Fontys-Pong/pong-PCB/pong_pcb/pong_pcb.kicad_pcb

## KiCad design pong_pcb/pong_pcb.kicad_pcb (2025-02-24)

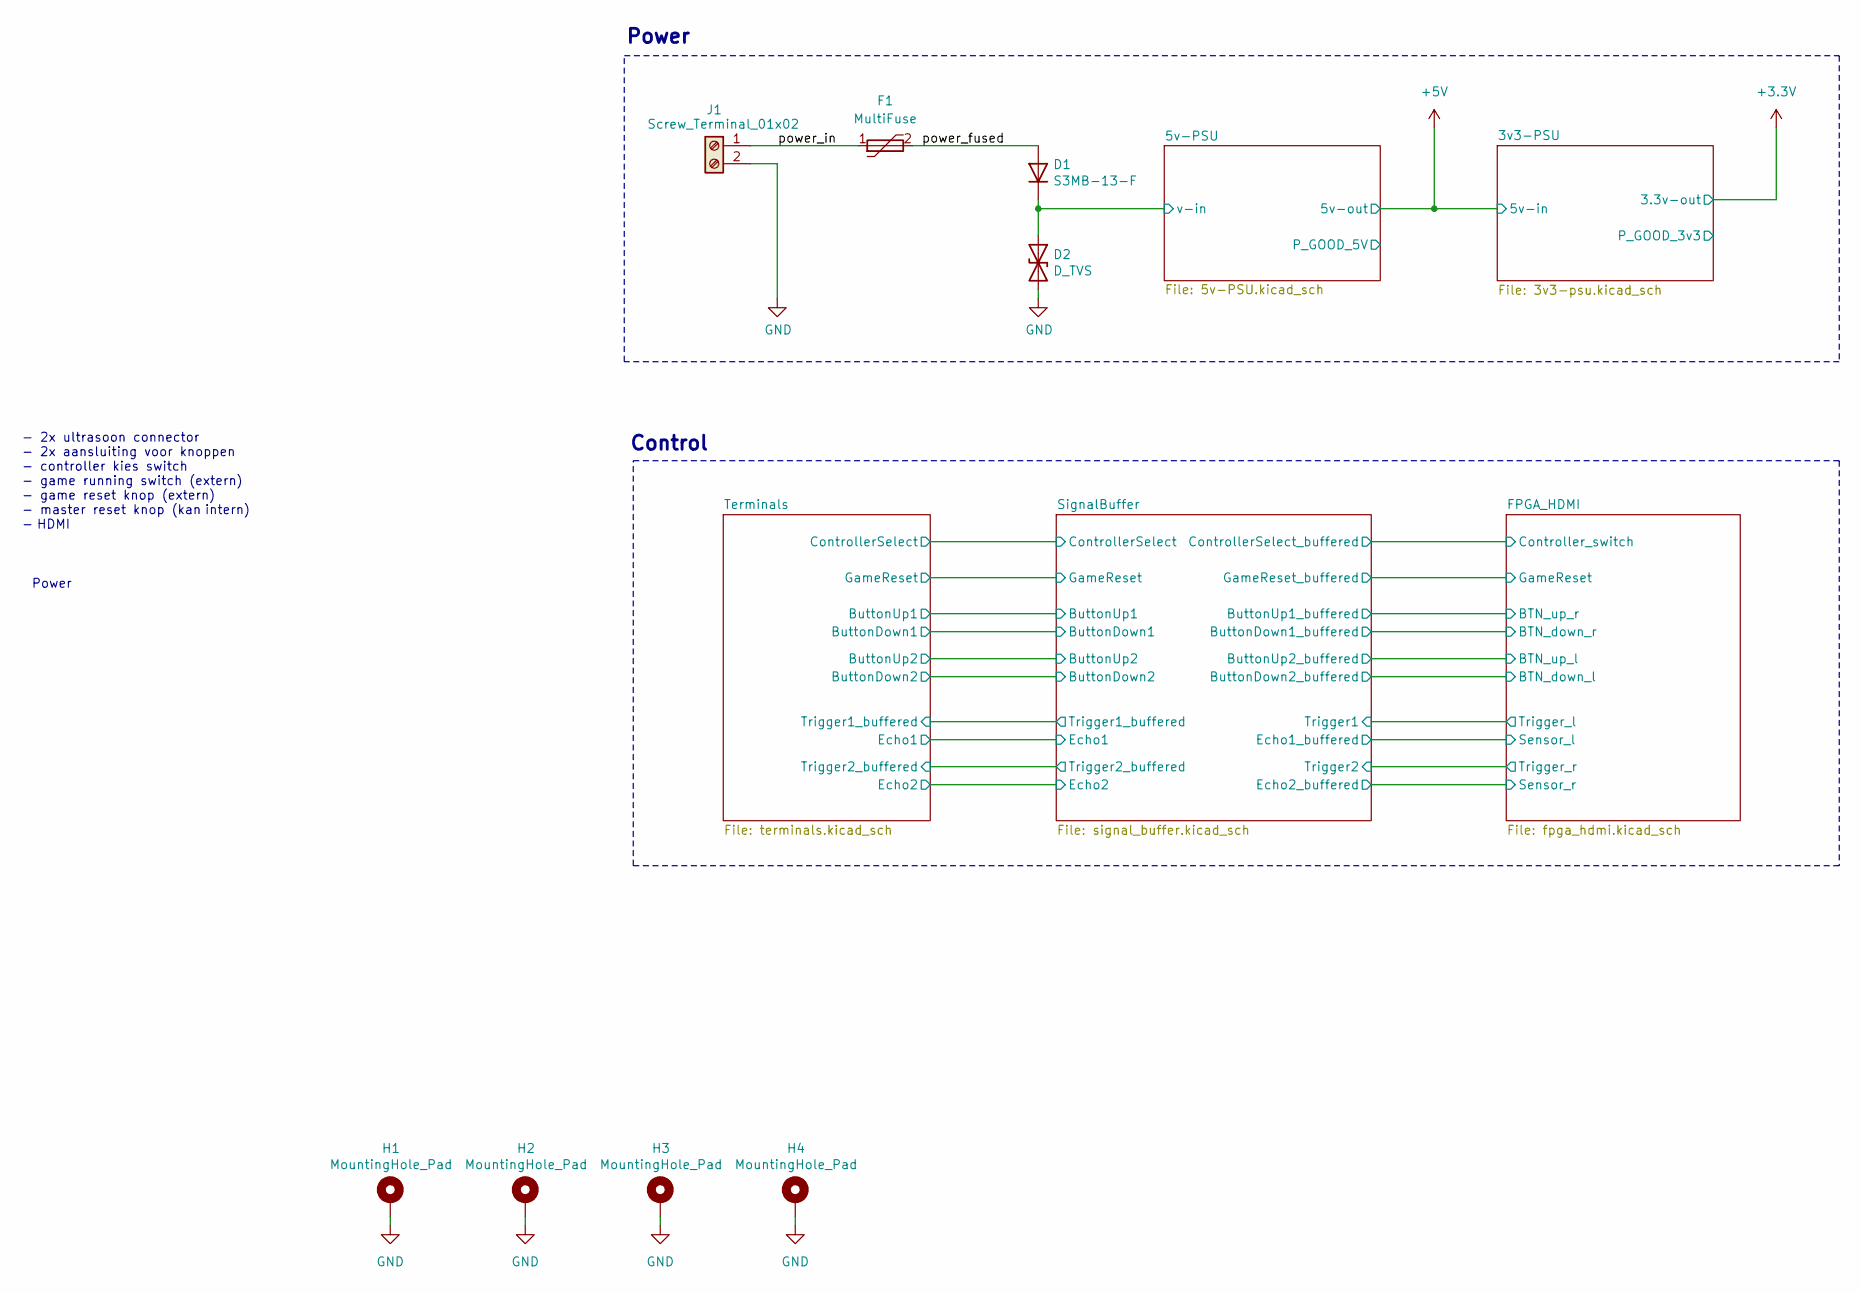
[picture p7: schematic pong_pcb.kicad_sch]

Parts:
D1: S3MB-13-F; D_SMB_Handsoldering; Mouser S3MB-13-F
D2: D_TVS; D_SMB_Handsoldering; Mouser 824520281
F1: MultiFuse; Fuse MF-MSMF075 33X-2; Mouser MF-MSMF075/33X-2
H1, H2, H3, H4: MountingHole_Pad; MountingHole_3.2mm_M3_Pad_Via
J1: Screw_Terminal_01x02; PhoenixContact_MSTBA_2,5_2-G-5,08_1x02_P5.08mm_Horizontal

Connections:
/5v-PSU/v-in: D1.1 (K), D2.1 (A1); also elsewhere on the board
/power_fused: D1.2 (A), F1.2
/power_in: F1.1, J1.1
GND: D2.2 (A2), H1.1, H2.1, H3.1, H4.1, J1.2; also elsewhere on the board

Notes on the sheet:
Power
- 2x ultrasoon connector - 2x aansluiting voor knoppen - controller kies switch - game running switch (extern) - game reset knop (extern) - master reset knop (kan intern) - HDMI
Control

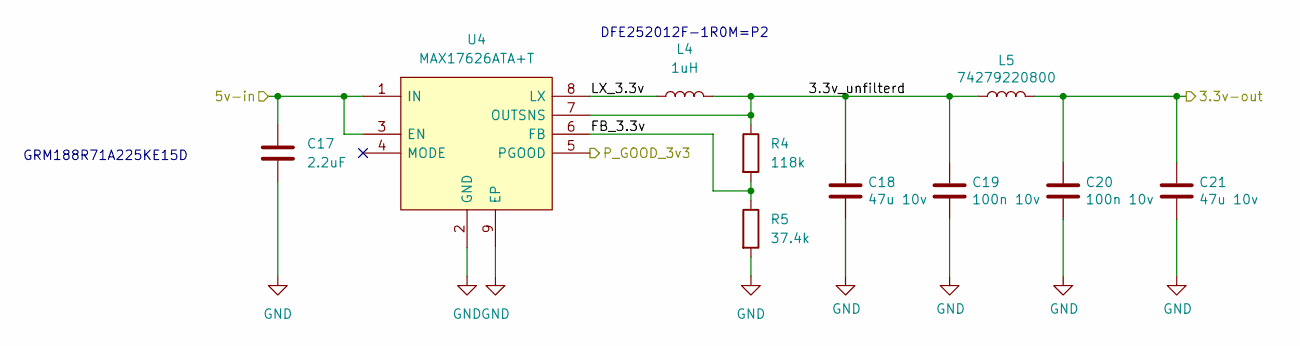
[picture p8: schematic 3v3-psu.kicad_sch, 3.3V power supply]

Parts:
C17: 2.2uF; C_0603_1608Metric
C18, C21: 47u 10v; C_1206_3216Metric_Pad1.33x1.80mm_HandSolder; Mouser LMK316BC6476ML-T
C19, C20: 100n 10v; C_0603_1608Metric; Mouser LMF105B7103MVHF
L4: 1uH; L_1008_2520Metric
L5: 74279220800; L_0805_2012Metric_Pad1.15x1.40mm_HandSolder; Mouser 74279220800
R4: 118k; R_0603_1608Metric
R5: 37.4k; R_0603_1608Metric
U4: MAX17626ATA+T; SON50P200X200X80-9N-D; Manufacturer_Part_Number MAX17626ATA+T; Mouser Part Number 700-MAX17626ATA+T

Connections:
+3.3V: C20.1, C21.1, L5.2; also elsewhere on the board
+5V: C17.1, U4.1 (IN), U4.3 (EN); also elsewhere on the board
/3v3-PSU/3.3v_unfilterd: C18.1, C19.1, L4.2, L5.1, R4.1, U4.7 (OUTSNS)
/3v3-PSU/FB_3.3v: R4.2, R5.1, U4.6 (FB)
/3v3-PSU/LX_3.3v: L4.1, U4.8 (LX)
/3v3-PSU/P_GOOD_3v3: U4.5 (PGOOD)
GND: C17.2, C18.2, C19.2, C20.2, C21.2, R5.2, U4.2 (GND), U4.9 (EP); also elsewhere on the board

Notes on the sheet:
GRM188R71A225KE15D
DFE252012F-1R0M=P2

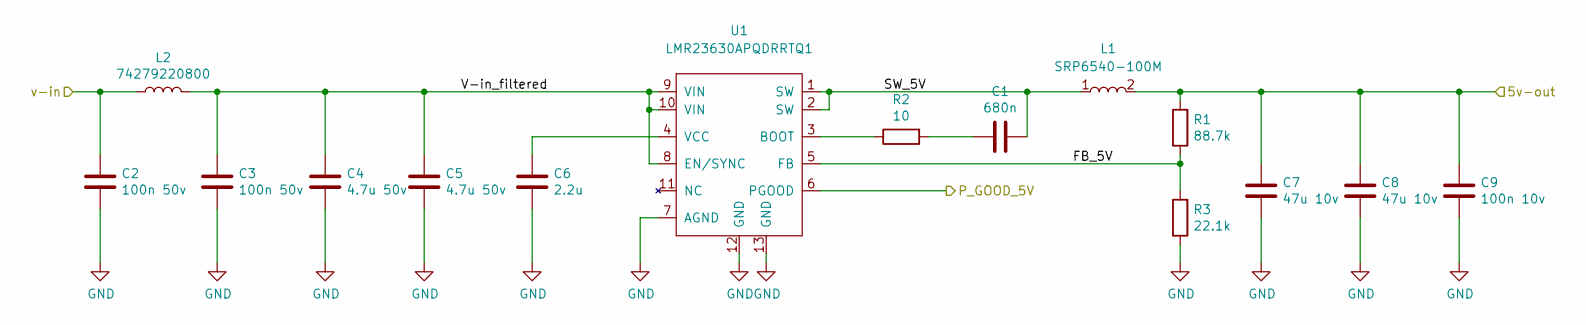
[picture p9: schematic 5v-PSU.kicad_sch, 5V power supply]

Parts:
C1: 680n; C_0603_1608Metric_Pad1.08x0.95mm_HandSolder; Mouser CGA3E1X7R1E684K080AC
C2, C3: 100n 50v; C_0805_2012Metric_Pad1.18x1.45mm_HandSolder; Mouser C0805C104KMRECAUTO
C4, C5: 4.7u 50v; C_0805_2012Metric_Pad1.18x1.45mm_HandSolder; Mouser C2012X7R1H475K125AC
C6: 2.2u; C_0603_1608Metric_Pad1.08x0.95mm_HandSolder; Mouser 963-TMK105CBJ225KV-F
C7, C8: 47u 10v; C_1206_3216Metric_Pad1.33x1.80mm_HandSolder; Mouser LMK316BC6476ML-T
C9: 100n 10v; C_0603_1608Metric; Mouser LMF105B7103MVHF
L1: SRP6540-100M; Mouser SRP6540-100M
L2: 74279220800; L_0805_2012Metric_Pad1.15x1.40mm_HandSolder; Mouser 74279220800
R1: 88.7k; R_0603_1608Metric; Mouser ERJ-2RKF8872X
R2: 10; R_0603_1608Metric; Mouser CRCW040210R0FKEDC
R3: 22.1k; R_0603_1608Metric; Mouser ERJ-2RHD2212X
U1: LMR23630APQDRRTQ1; Mouser LMR23630APQDRRTQ1

Connections:
+5V: C7.1, C8.1, C9.1, L1.2, R1.2; also elsewhere on the board
/5v-PSU/FB_5V: R1.1, R3.2, U1.5 (FB)
/5v-PSU/P_GOOD_5V: U1.6 (PGOOD)
/5v-PSU/SW_5V: C1.1, L1.1, U1.1 (SW), U1.2 (SW)
/5v-PSU/V-in_filtered: C3.1, C4.1, C5.1, L2.2, U1.8 (EN/SYNC), U1.9 (VIN), U1.10 (VIN)
/5v-PSU/v-in: C2.1, L2.1; also elsewhere on the board
GND: C2.2, C3.2, C4.2, C5.2, C6.2, C7.2, C8.2, C9.2, R3.1, U1.7 (AGND), U1.12 (GND), U1.13 (GND); also elsewhere on the board
unnamed: C1.2, R2.2
unnamed: R2.1, U1.3 (BOOT)
unnamed: C6.1, U1.4 (VCC)

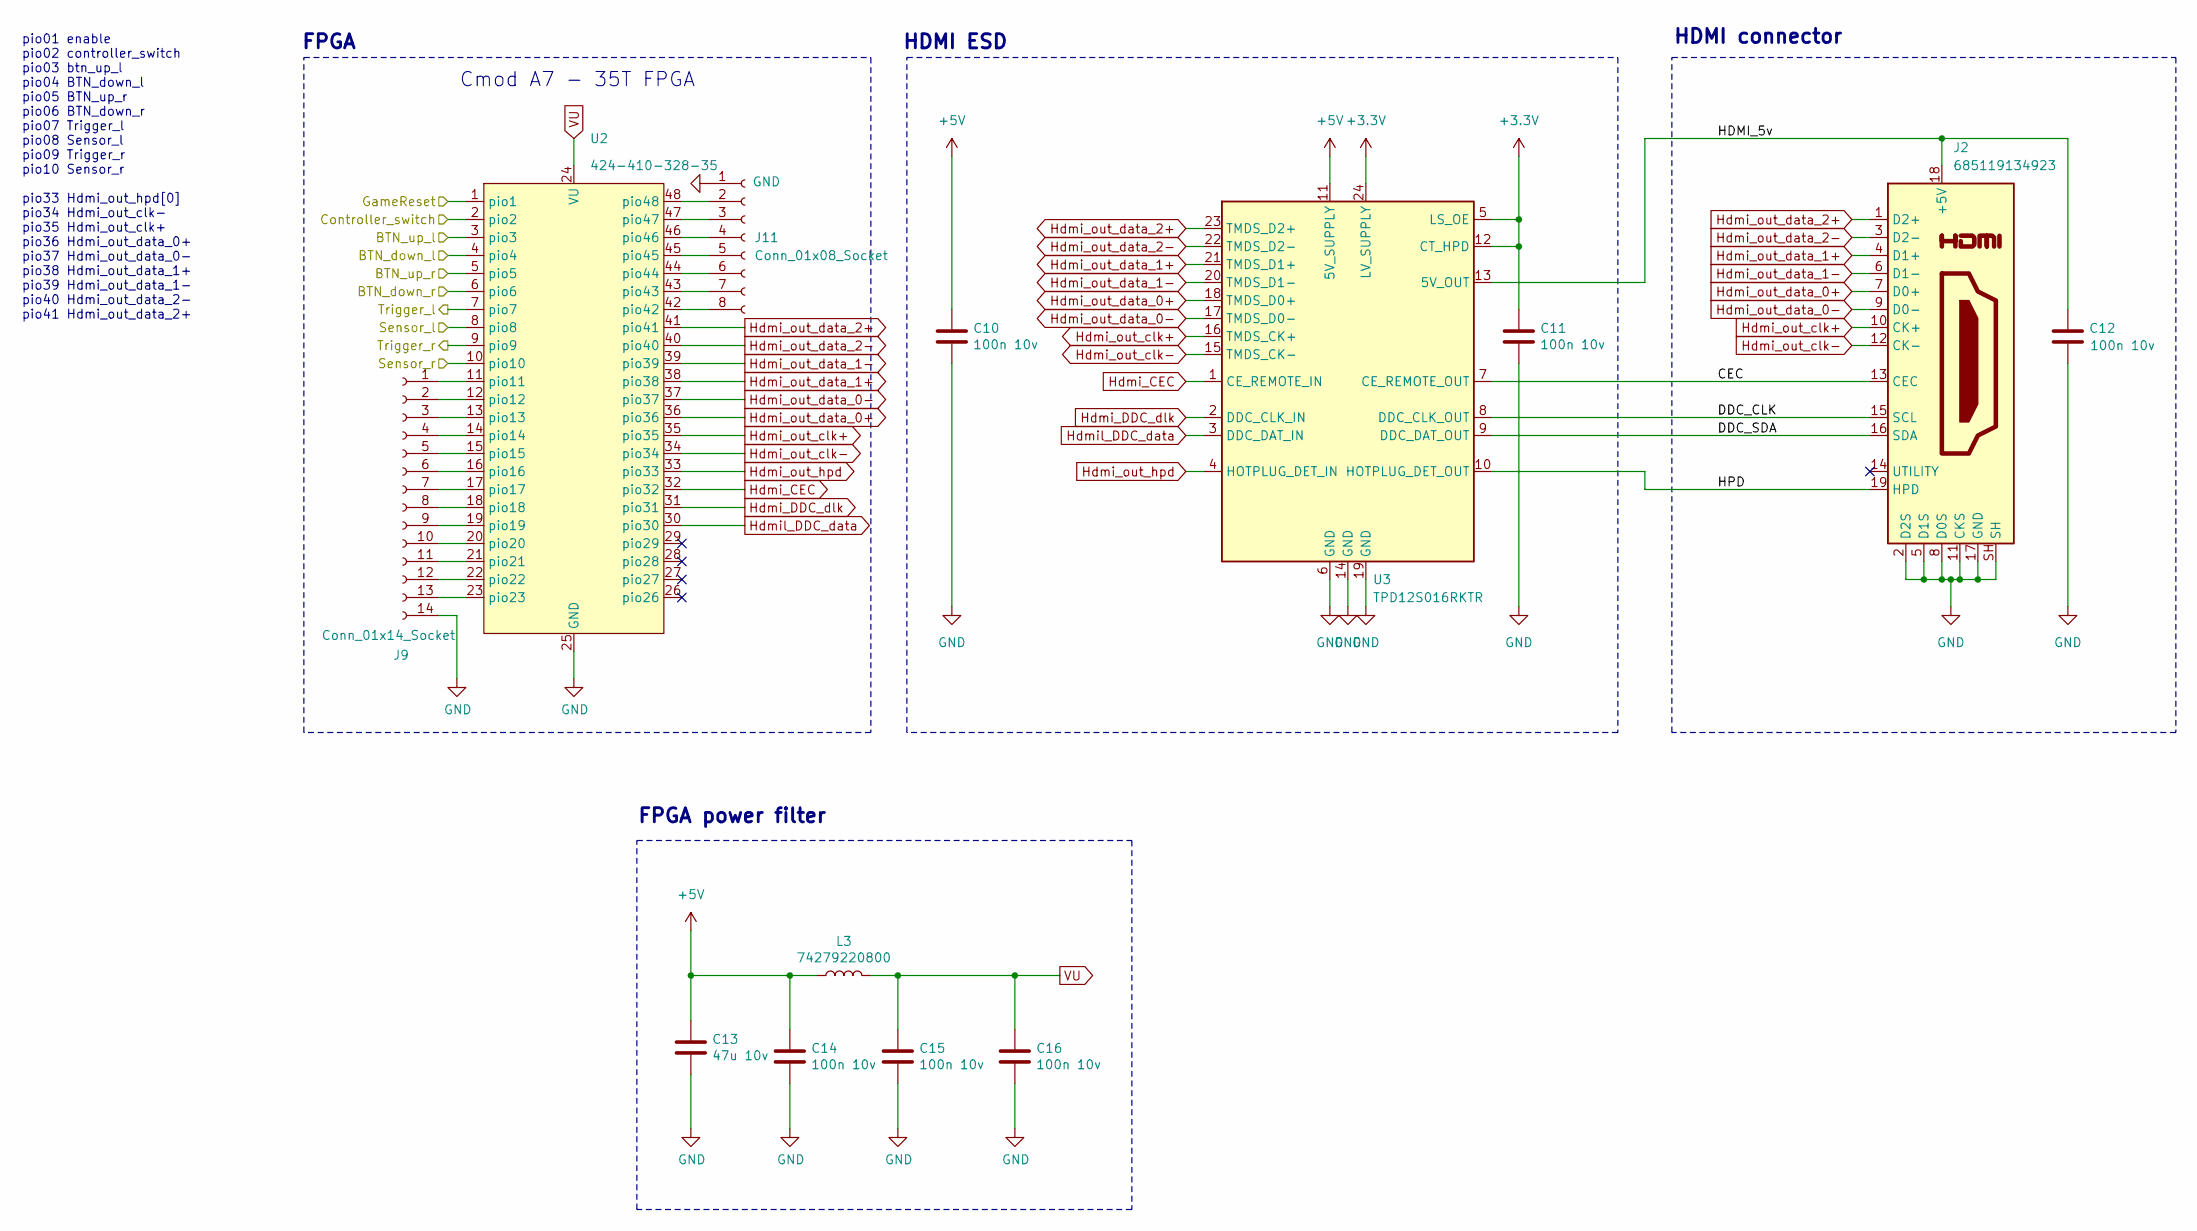
[picture p10: schematic fpga_hdmi.kicad_sch, FPGA + HDMI]

Parts:
C10, C11, C12, C14, C15, C16: 100n 10v; C_0603_1608Metric; Mouser LMF105B7103MVHF
C13: 47u 10v; C_1206_3216Metric_Pad1.33x1.80mm_HandSolder; Mouser LMK316BC6476ML-T
J2: 685119134923
J9: Conn_01x14_Socket; PinSocket_2x07_P2.54mm_Vertical
J11: Conn_01x08_Socket; PinSocket_2x04_P2.54mm_Vertical
L3: 74279220800; L_0805_2012Metric_Pad1.15x1.40mm_HandSolder; Mouser 74279220800
U2: CmodA7; Mouser 424-410-328-35
U3: TPD12S016RKTR; TSSOP-24_4.4x7.8mm_P0.65mm

Connections:
+3.3V: C11.1, U3.5 (LS_OE), U3.12 (CT_HPD), U3.24 (LV_SUPPLY); also elsewhere on the board
+5V: C10.1, C13.1, C14.1, L3.1, U3.11 (5V_SUPPLY); also elsewhere on the board
/FPGA_HDMI/BTN_down_l: U2.4 (pio4); also elsewhere on the board
/FPGA_HDMI/BTN_down_r: U2.6 (pio6); also elsewhere on the board
/FPGA_HDMI/BTN_up_l: U2.3 (pio3); also elsewhere on the board
/FPGA_HDMI/BTN_up_r: U2.5 (pio5); also elsewhere on the board
/FPGA_HDMI/CEC: J2.13 (CEC), U3.7 (CE_REMOTE_OUT)
/FPGA_HDMI/Controller_switch: U2.2 (pio2); also elsewhere on the board
/FPGA_HDMI/DDC_CLK: J2.15 (SCL), U3.8 (DDC_CLK_OUT)
/FPGA_HDMI/DDC_SDA: J2.16 (SDA), U3.9 (DDC_DAT_OUT)
/FPGA_HDMI/GameReset: U2.1 (pio1); also elsewhere on the board
/FPGA_HDMI/HDMI_5v: C12.1, J2.18 (+5V), U3.13 (5V_OUT)
/FPGA_HDMI/HPD: J2.19 (HPD), U3.10 (HOTPLUG_DET_OUT)
/FPGA_HDMI/Sensor_l: U2.8 (pio8); also elsewhere on the board
/FPGA_HDMI/Sensor_r: U2.10 (pio10); also elsewhere on the board
/FPGA_HDMI/Trigger_l: U2.7 (pio7); also elsewhere on the board
/FPGA_HDMI/Trigger_r: U2.9 (pio9); also elsewhere on the board
GND: C10.2, C11.2, C12.2, C13.2, C14.2, C15.2, C16.2, J2.2 (D2S), J2.5 (D1S), J2.8 (D0S), J2.11 (CKS), J2.17 (GND), J2.SH, J9.14, J11.1, U2.25 (GND), U3.6 (GND), U3.14 (GND), U3.19 (GND); also elsewhere on the board
Hdmi_CEC: U2.32 (pio32), U3.1 (CE_REMOTE_IN)
Hdmi_DDC_dlk: U2.31 (pio31), U3.2 (DDC_CLK_IN)
Hdmi_out_clk+: J2.10 (CK+), U2.35 (pio35), U3.16 (TMDS_CK+)
Hdmi_out_clk-: J2.12 (CK-), U2.34 (pio34), U3.15 (TMDS_CK-)
Hdmi_out_data_0+: J2.7 (D0+), U2.36 (pio36), U3.18 (TMDS_D0+)
Hdmi_out_data_0-: J2.9 (D0-), U2.37 (pio37), U3.17 (TMDS_D0-)
Hdmi_out_data_1+: J2.4 (D1+), U2.38 (pio38), U3.21 (TMDS_D1+)
Hdmi_out_data_1-: J2.6 (D1-), U2.39 (pio39), U3.20 (TMDS_D1-)
Hdmi_out_data_2+: J2.1 (D2+), U2.41 (pio41), U3.23 (TMDS_D2+)
Hdmi_out_data_2-: J2.3 (D2-), U2.40 (pio40), U3.22 (TMDS_D2-)
Hdmi_out_hpd: U2.33 (pio33), U3.4 (HOTPLUG_DET_IN)
Hdmil_DDC_data: U2.30 (pio30), U3.3 (DDC_DAT_IN)
unnamed: J9.1, U2.11 (pio11)
unnamed: J9.2, U2.12 (pio12)
unnamed: J9.3, U2.13 (pio13)
unnamed: J9.4, U2.14 (pio14)
unnamed: J9.5, U2.15 (pio15)
unnamed: J9.6, U2.16 (pio16)
unnamed: J9.7, U2.17 (pio17)
unnamed: J9.8, U2.18 (pio18)
unnamed: J9.9, U2.19 (pio19)
unnamed: J9.10, U2.20 (pio20)
unnamed: J9.11, U2.21 (pio21)
unnamed: J9.12, U2.22 (pio22)
unnamed: J9.13, U2.23 (pio23)
unnamed: J11.2, U2.48 (pio48)
unnamed: J11.3, U2.47 (pio47)
unnamed: J11.4, U2.46 (pio46)
unnamed: J11.5, U2.45 (pio45)
unnamed: J11.6, U2.44 (pio44)
unnamed: J11.7, U2.43 (pio43)
unnamed: J11.8, U2.42 (pio42)
VU: C15.1, C16.1, L3.2, U2.24 (VU)

Notes on the sheet:
FPGA
pio01 enable pio02 controller_switch pio03 btn_up_l pio04 BTN_down_l pio05 BTN_up_r pio06 BTN_down_r pio07 Trigger_l pio08 Sensor_l pio09 Trigger_r pio10 Sensor_r pio33 Hdmi_out_hpd[0] pio34 Hdmi_out_clk- pio35 Hdmi_out_clk+ pio36 Hdmi_out_data_0+ pio37 Hdmi_out_data_0- pio38 Hdmi_out_data_1+ pio39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
FPGA power filter
Cmod A7 - 35T FPGA
HDMI ESD
HDMI connector

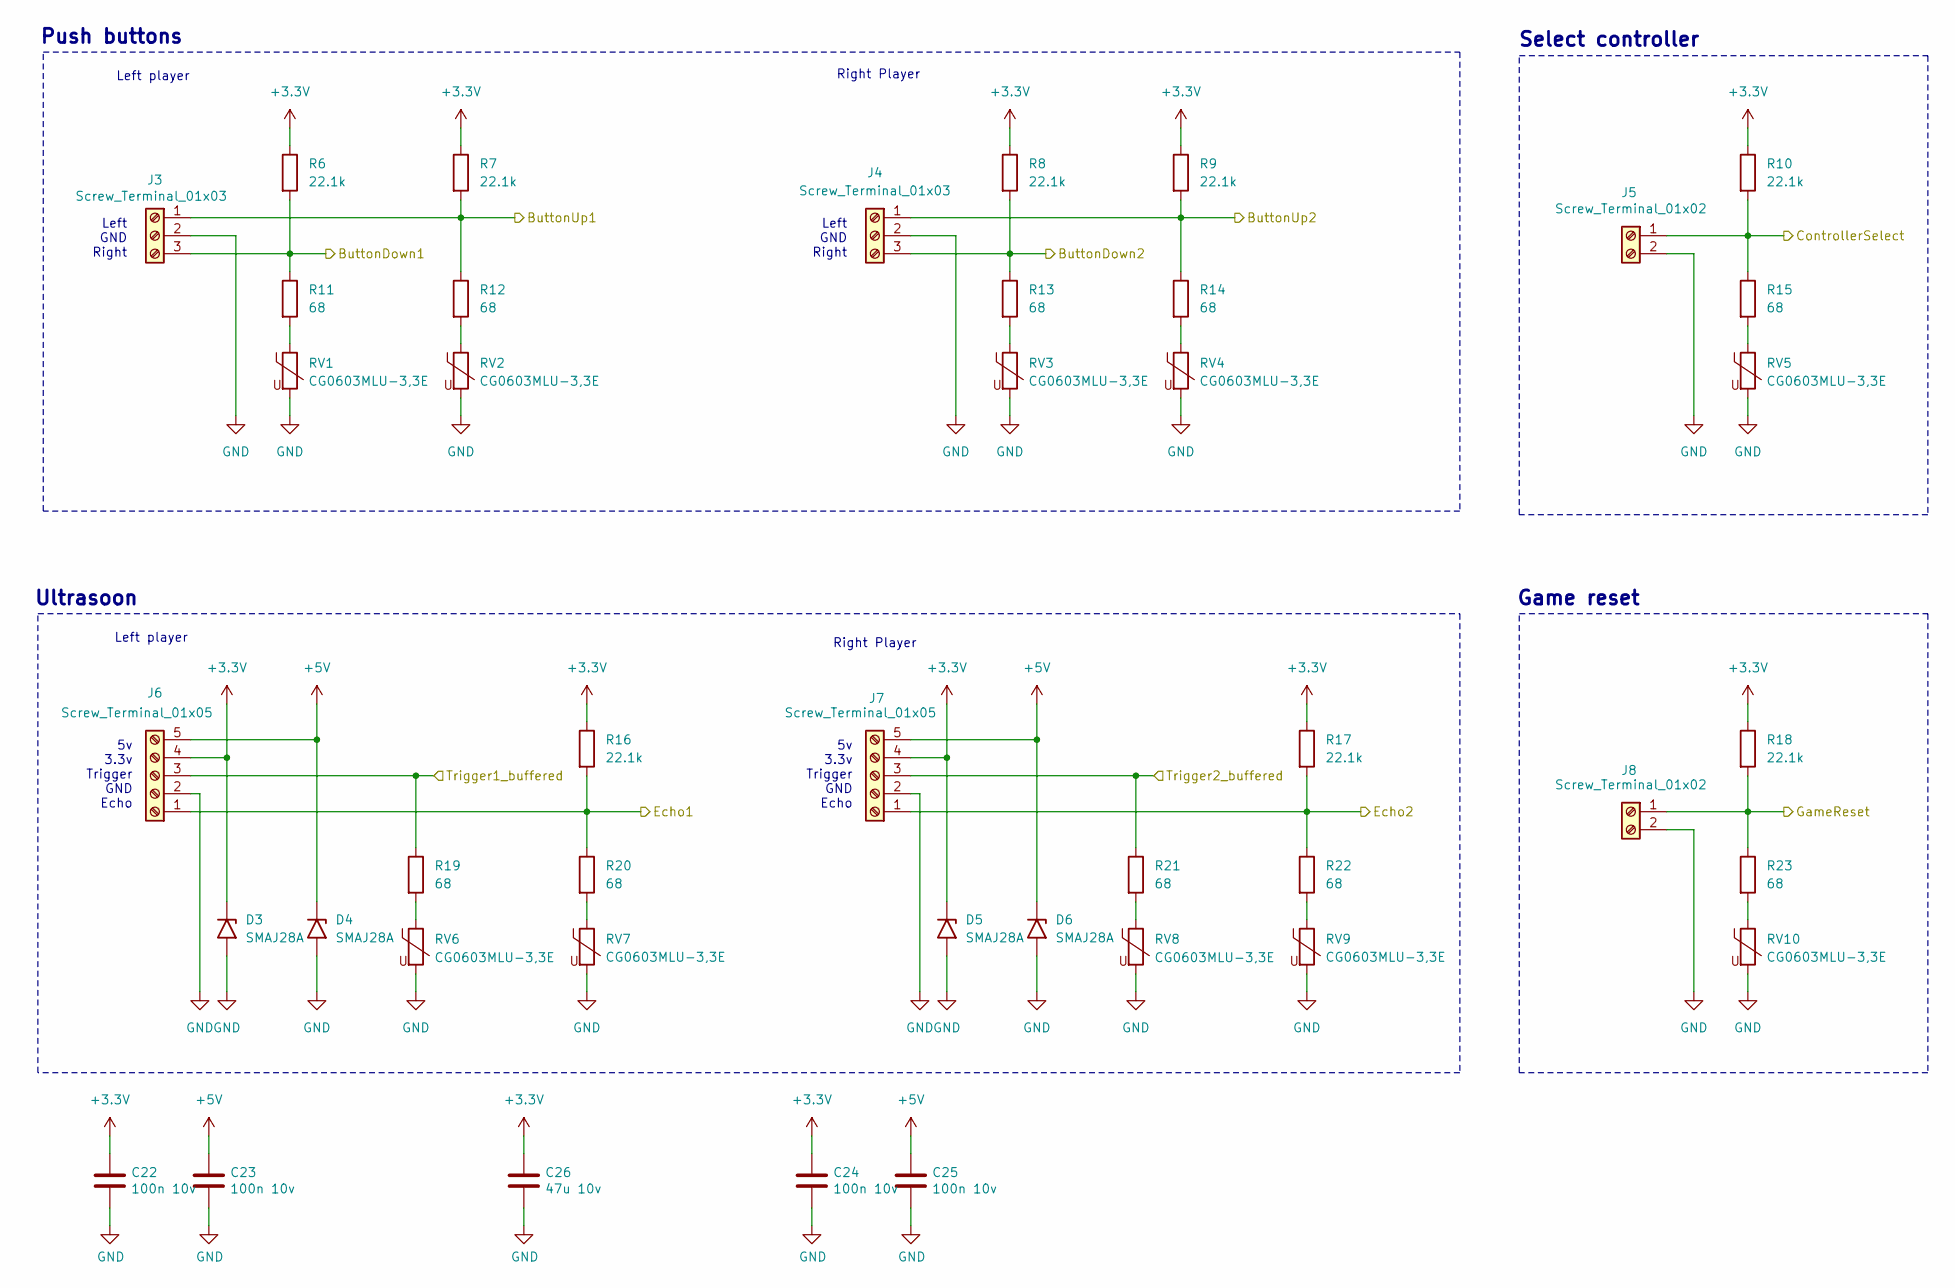
[picture p11: schematic terminals.kicad_sch]

Parts:
C22, C23, C24, C25: 100n 10v; C_0603_1608Metric; Mouser LMF105B7103MVHF
C26: 47u 10v; C_1206_3216Metric_Pad1.33x1.80mm_HandSolder; Mouser LMK316BC6476ML-T
D3, D4, D5, D6: SMAJ28A; D_SMA
J3, J4: Screw_Terminal_01x03; PhoenixContact_MSTBA_2,5_3-G-5,08_1x03_P5.08mm_Horizontal
J5, J8: Screw_Terminal_01x02; PhoenixContact_MSTBA_2,5_2-G-5,08_1x02_P5.08mm_Horizontal
J6, J7: Screw_Terminal_01x05; PhoenixContact_MSTBA_2,5_5-G-5,08_1x05_P5.08mm_Horizontal
R6, R7, R8, R9, R10, R16, R17, R18: 22.1k; R_0603_1608Metric
R11, R12, R13, R14, R15, R19, R20, R21, R22, R23: 68; R_0603_1608Metric
RV1, RV2, RV3, RV4, RV5, RV6, RV7, RV8, RV9, RV10: CG0603MLU-3,3E; R_0603_1608Metric

Connections:
+3.3V: C22.1, C24.1, C26.1, D3.1 (A1), D5.1 (A1), J6.4, J7.4, R6.1, R7.1, R8.1, R9.1, R10.1, R16.1, R17.1, R18.1; also elsewhere on the board
+5V: C23.1, C25.1, D4.1 (A1), D6.1 (A1), J6.5, J7.5; also elsewhere on the board
/SignalBuffer/ButtonDown1: J3.3, R6.2, R11.1; also elsewhere on the board
/SignalBuffer/ButtonDown2: J4.3, R8.2, R13.1; also elsewhere on the board
/SignalBuffer/ButtonUp1: J3.1, R7.2, R12.1; also elsewhere on the board
/SignalBuffer/ButtonUp2: J4.1, R9.2, R14.1; also elsewhere on the board
/SignalBuffer/ControllerSelect: J5.1, R10.2, R15.1; also elsewhere on the board
/SignalBuffer/Echo1: J6.1, R16.2, R20.1; also elsewhere on the board
/SignalBuffer/Echo2: J7.1, R17.2, R22.1; also elsewhere on the board
/SignalBuffer/GameReset: J8.1, R18.2, R23.1; also elsewhere on the board
/SignalBuffer/Trigger1_buffered: J6.3, R19.1; also elsewhere on the board
/SignalBuffer/Trigger2_buffered: J7.3, R21.1; also elsewhere on the board
GND: C22.2, C23.2, C24.2, C25.2, C26.2, D3.2 (A2), D4.2 (A2), D5.2 (A2), D6.2 (A2), J3.2, J4.2, J5.2, J6.2, J7.2, J8.2, RV1.2, RV2.2, RV3.2, RV4.2, RV5.2, RV6.2, RV7.2, RV8.2, RV9.2, RV10.2; also elsewhere on the board
unnamed: R11.2, RV1.1
unnamed: R12.2, RV2.1
unnamed: R13.2, RV3.1
unnamed: R14.2, RV4.1
unnamed: R15.2, RV5.1
unnamed: R19.2, RV6.1
unnamed: R20.2, RV7.1
unnamed: R21.2, RV8.1
unnamed: R22.2, RV9.1
unnamed: R23.2, RV10.1

Notes on the sheet:
5v 3.3v Trigger GND Echo
Ultrasoon
Game reset
Left GND Right
Push buttons
Left player
Right Player
Select controller

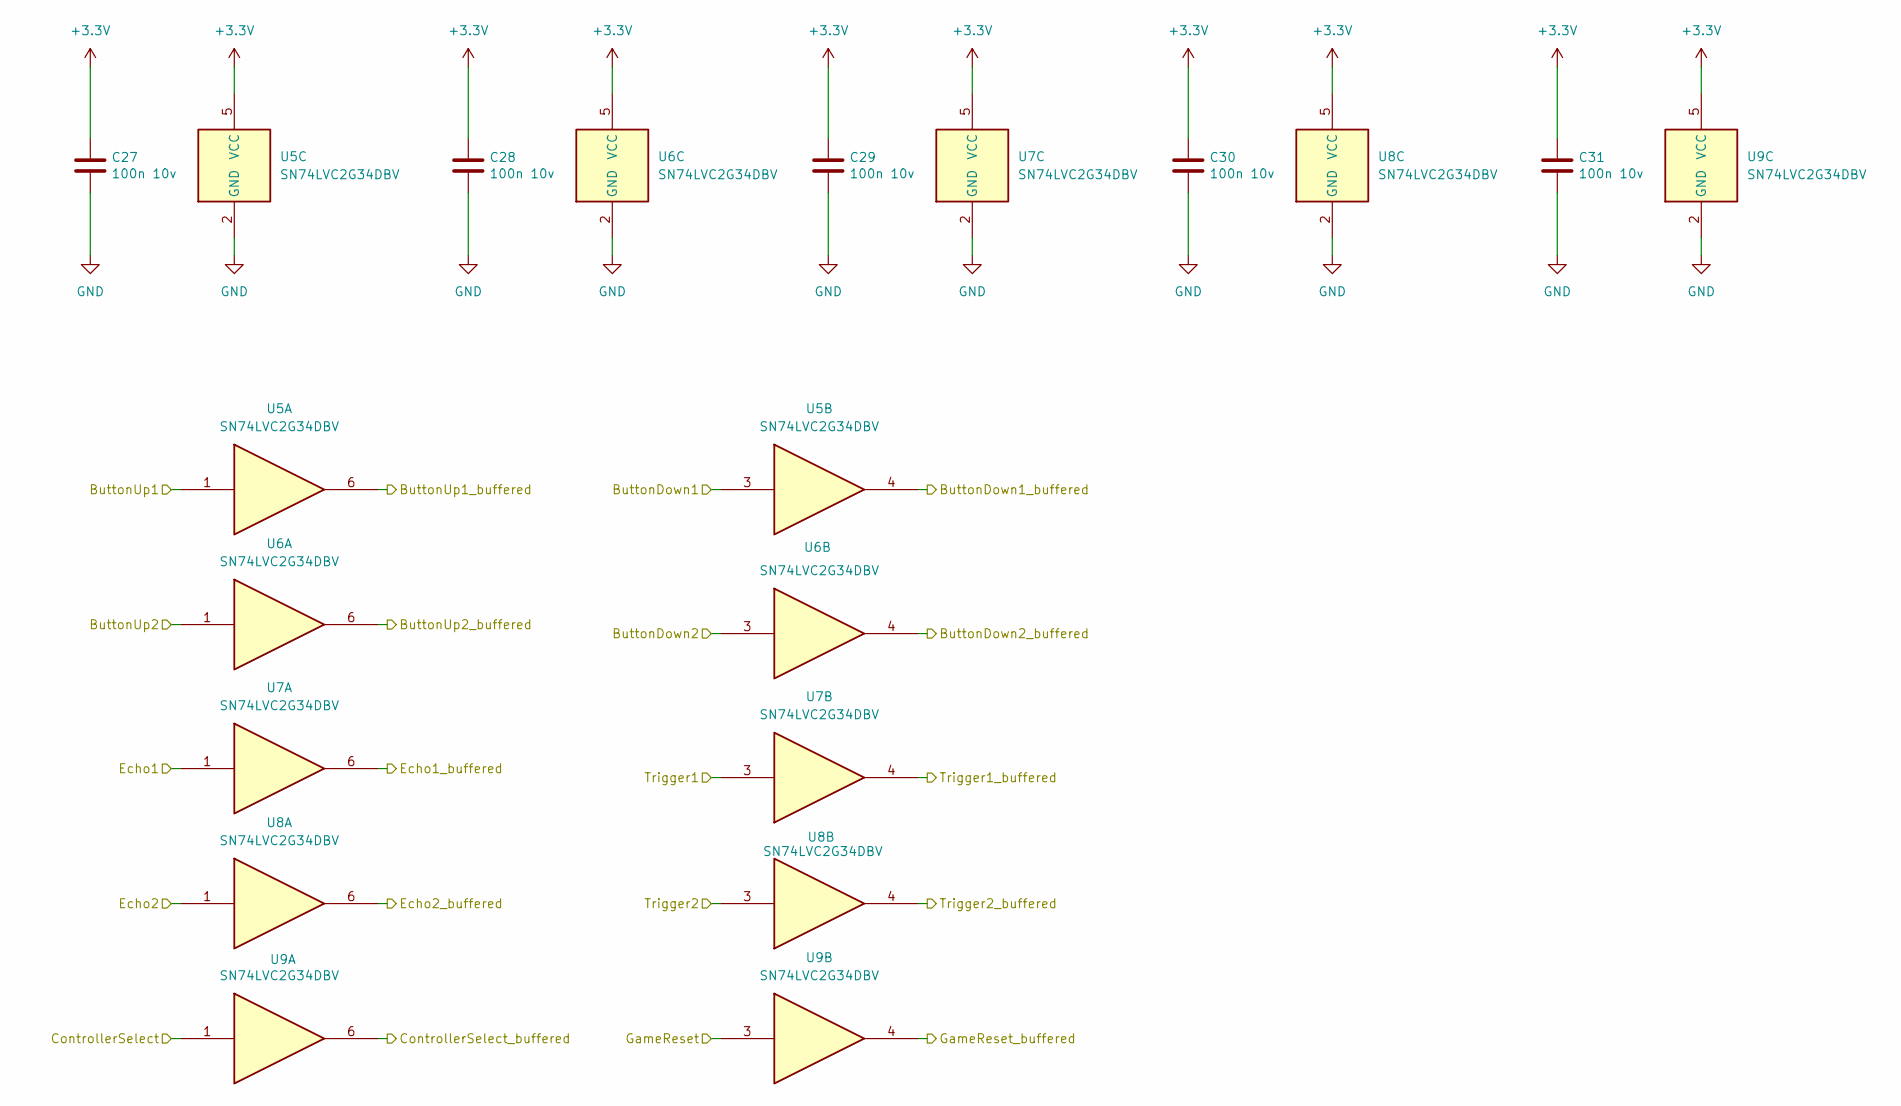
[picture p12: schematic signal_buffer.kicad_sch, Signal buffers]

Parts:
C27, C28, C29, C30, C31: 100n 10v; C_0603_1608Metric; Mouser LMF105B7103MVHF
U5, U6, U7, U8, U9: SN74LVC2G34DBV; SOT-23-6_Handsoldering

Connections:
+3.3V: C27.1, C28.1, C29.1, C30.1, C31.1, U5.5 (VCC), U6.5 (VCC), U7.5 (VCC), U8.5 (VCC), U9.5 (VCC); also elsewhere on the board
/FPGA_HDMI/BTN_down_l: U6.4; also elsewhere on the board
/FPGA_HDMI/BTN_down_r: U5.4; also elsewhere on the board
/FPGA_HDMI/BTN_up_l: U6.6; also elsewhere on the board
/FPGA_HDMI/BTN_up_r: U5.6; also elsewhere on the board
/FPGA_HDMI/Controller_switch: U9.6; also elsewhere on the board
/FPGA_HDMI/GameReset: U9.4; also elsewhere on the board
/FPGA_HDMI/Sensor_l: U7.6; also elsewhere on the board
/FPGA_HDMI/Sensor_r: U8.6; also elsewhere on the board
/FPGA_HDMI/Trigger_l: U7.3; also elsewhere on the board
/FPGA_HDMI/Trigger_r: U8.3; also elsewhere on the board
/SignalBuffer/ButtonDown1: U5.3; also elsewhere on the board
/SignalBuffer/ButtonDown2: U6.3; also elsewhere on the board
/SignalBuffer/ButtonUp1: U5.1; also elsewhere on the board
/SignalBuffer/ButtonUp2: U6.1; also elsewhere on the board
/SignalBuffer/ControllerSelect: U9.1; also elsewhere on the board
/SignalBuffer/Echo1: U7.1; also elsewhere on the board
/SignalBuffer/Echo2: U8.1; also elsewhere on the board
/SignalBuffer/GameReset: U9.3; also elsewhere on the board
/SignalBuffer/Trigger1_buffered: U7.4; also elsewhere on the board
/SignalBuffer/Trigger2_buffered: U8.4; also elsewhere on the board
GND: C27.2, C28.2, C29.2, C30.2, C31.2, U5.2 (GND), U6.2 (GND), U7.2 (GND), U8.2 (GND), U9.2 (GND); also elsewhere on the board

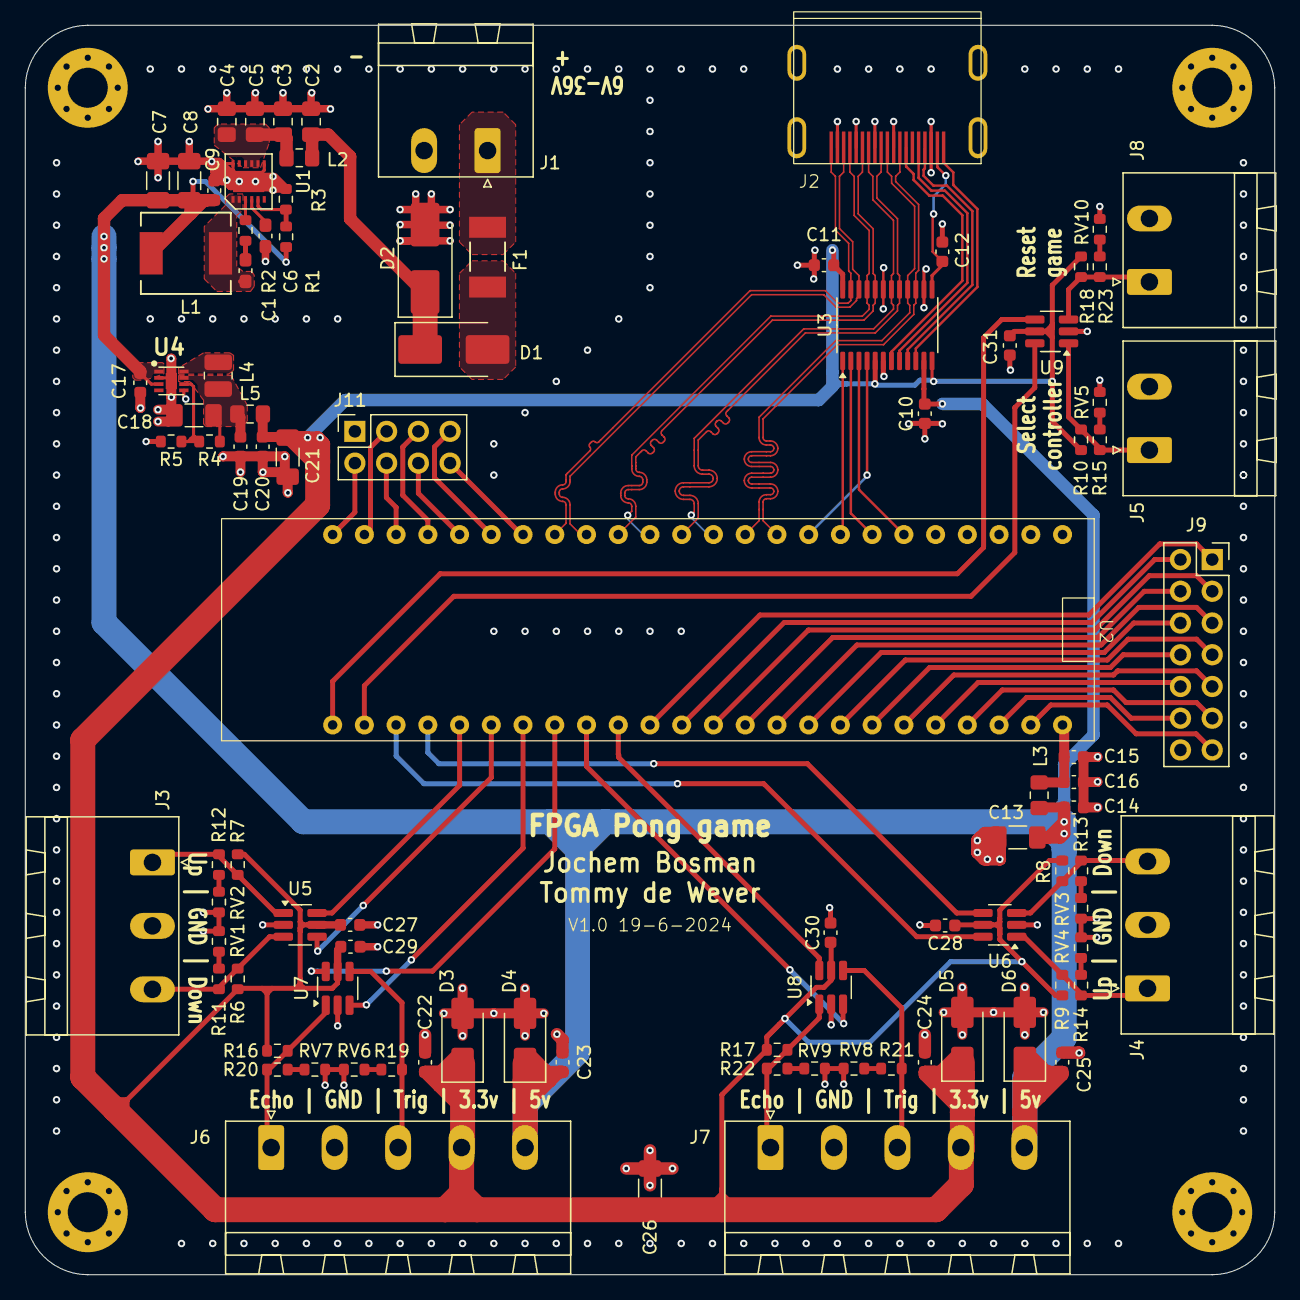
[picture p13: board pong_pcb.kicad_pcb from above]

Board: 4 copper layers, 100.0 x 100.0 mm, 99 parts (0 on the bottom side), 83 nets.
