Fontys-Pong/pong-PCB/(commit log)

2024-04-03 Update schema and add packages
    [3v3-psu.kicad_sch, 5v-PSU.kicad_sch, fpga_hdmi.kicad_sch, pong_pcb.kicad_sch, signal_buffer.kicad_sch, terminals.kicad_sch]
2024-04-05 Add HDMI layout
    And others
    [3v3-psu.kicad_sch, 5v-PSU.kicad_sch, fpga_hdmi.kicad_sch, pong_pcb.kicad_pcb, signal_buffer.kicad_sch, terminals.kicad_sch]
2024-04-05 PCB indeling maken
    [pong_pcb.kicad_pcb, pong_pcb.kicad_sch]
2024-04-07 Update schema and route PCB
    [3v3-psu.kicad_sch, 5v-PSU.kicad_sch, fpga_hdmi.kicad_sch, pong_pcb.kicad_pcb, pong_pcb.kicad_sch, signal_buffer.kicad_sch, terminals.kicad_sch]
2024-04-08 Other connectors
    [fpga_hdmi.kicad_sch, pong_pcb.kicad_pcb, pong_pcb.kicad_sch, terminals.kicad_sch]
2024-06-18 Add header pins
    [fpga_hdmi.kicad_sch, pong_pcb.kicad_pcb]
2024-06-19 Update TODOs
    [fpga_hdmi.kicad_sch, pong_pcb.kicad_pcb]
2025-02-22 Interactive BOM + PDF Schema
